bigcookie/jetibox_micro/pdfs/Arduino meets EA DOGM081 DOGM162 DOGM163 Rev_A_schematic.pdf

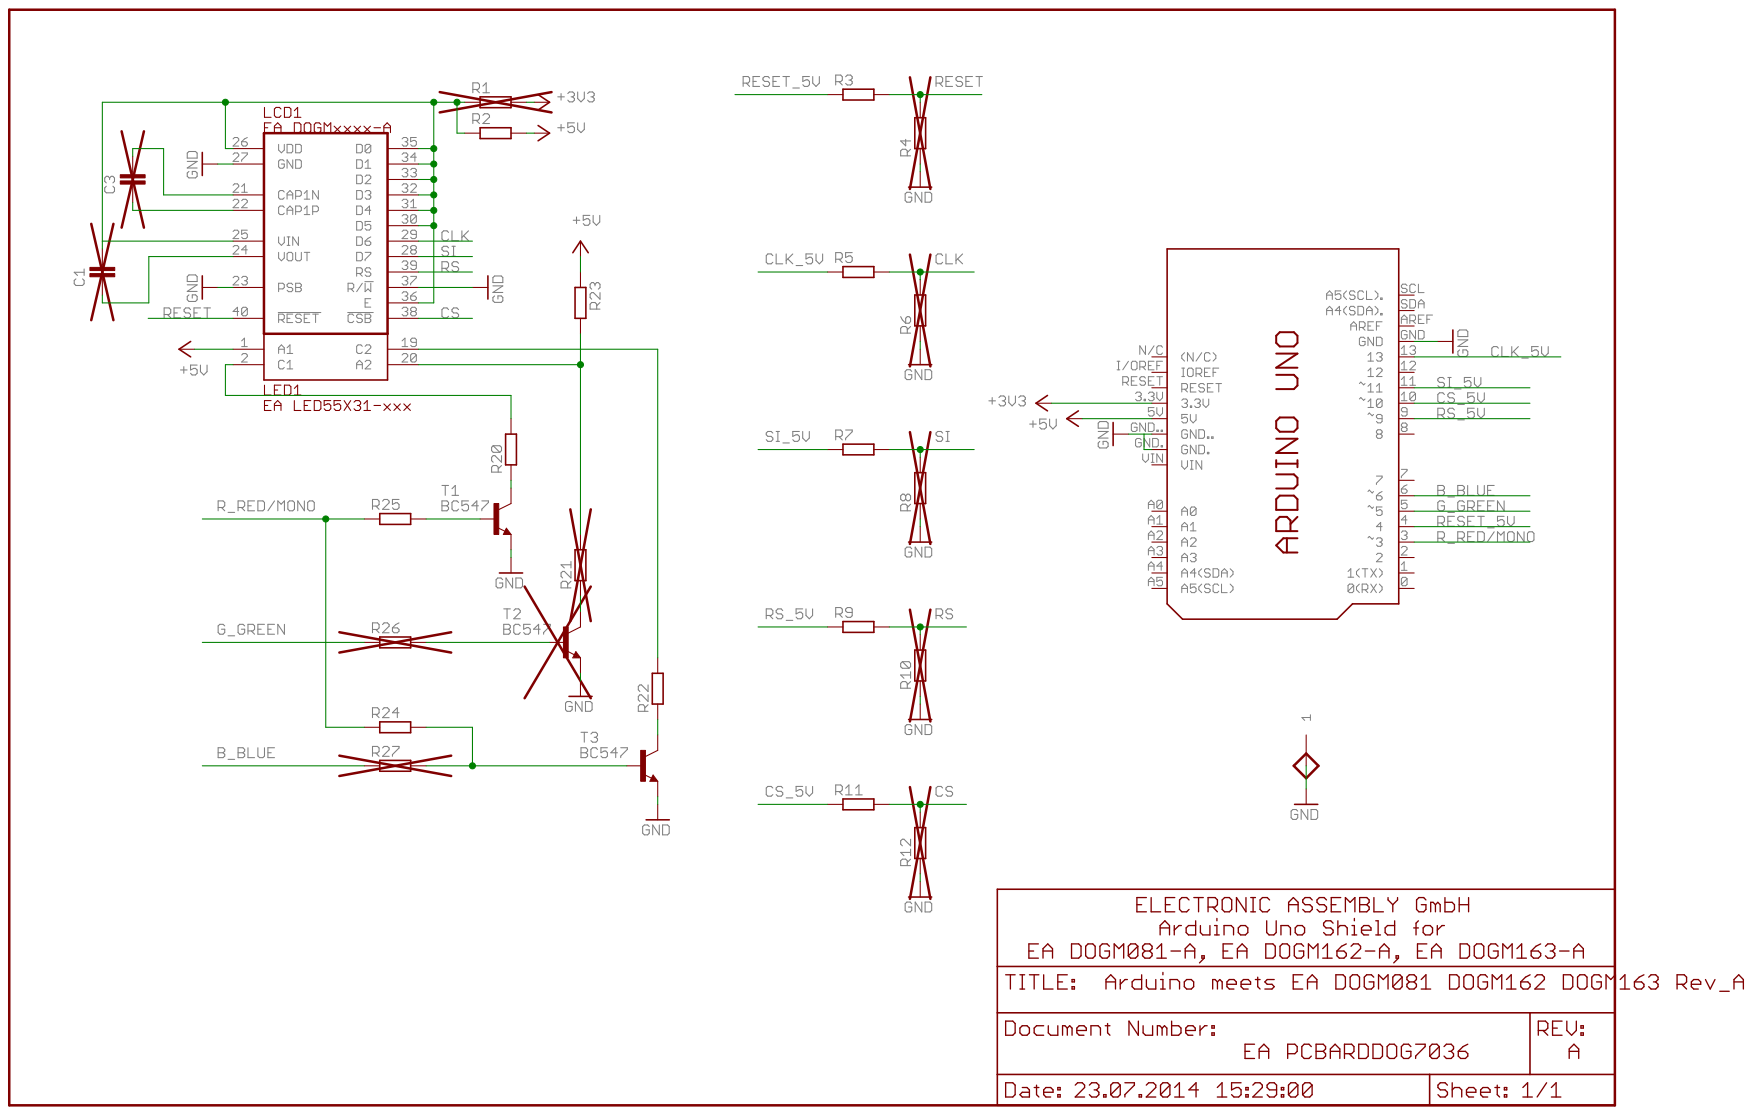
[picture p6: page 1]
