bigcookie/jetibox_micro/(commit log)

2024-02-26 Added block schematic png and updated Readme accordingly
2024-02-26 Fix comments in ino file
    [jetibox_micro_dogm.ino]
2024-02-27 Added support for 2x16 display - can be configured before compiling. Added DOGM library readme and schematic
2025-02-27 Fixed Duplex Receiver support and simplified code
    Added delay for button code sending as jeti receivers don't switch quickly enough to receiving mode after transmitting the data.
    Simplified button send routine (removed if statements)
    Simplified text extraction
    [jetibox_micro_dogm.ino]
2025-02-27 Fixed 16x2 dot matrix support
    Accidently Reset pin definition of DOGM and 16x2 displays had the same name, but different values. As such, hardware connection was incorrect. Fixed definition naming.
    [jetibox_micro_dogm.ino]
2025-02-27 Improvement: Show startup screen when removing Jeti device
    Originally startup screen or new screen was only shown, when a new device was connected, now the Jetibox Micro also goes back to startup screen when you remove a device.
2025-02-27 Simplified Timer interrupt service routine
2025-02-28 Fixed 16x2 display and REX receiver support
    - Fixed: 16x2 matrix displays wouldn't work due to wrong configuration of RS pin
    - Fixed: REX receivers not supported, as they switch too slowly between serial transmitter and receiver mode.
2025-02-28 Fixed 16x2 display and REX receiver support.
    - Fixed: wrong RS pin definition for 16x2 displays
    - Fixed: Jeti REX receivers were not supported due to their slow switching between serial transmit and receiver mode
2025-02-28 Improved text extraction to be more flexible
    Changed the extraction routing to be more flexible. This made the loop function shorter and faster.
    [jetibox_micro_dogm.ino]
